n1k0m0/BackLight/Misc/schematics.pptx

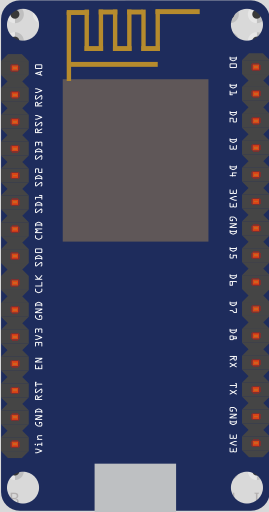
[picture p4: figure]

VCC

Ground
