n1k0m0/BackLight/(commit log)

2019-09-11 Update ESPServer.ino
    small fix in wlan ssid string
    [ESPServer.ino]
2019-09-11 added schematics
2019-09-13 * added exception handling (just ignore it :-) ) to Timer_Tick * set DebugDraw to false per default
2019-09-13 * fixed bug with save button (was always active) * added setting for allowing the user to decide whether or not to disable strip when the application is closed * created new release * updated setting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
2021-10-26 * Server automatically fades LEDs at startup now * removed add of average color by setting default value in constants to 0
